gdebrun2/FlowMonitor/Plots/DPS310 Pressure Change Versus Elevation.png

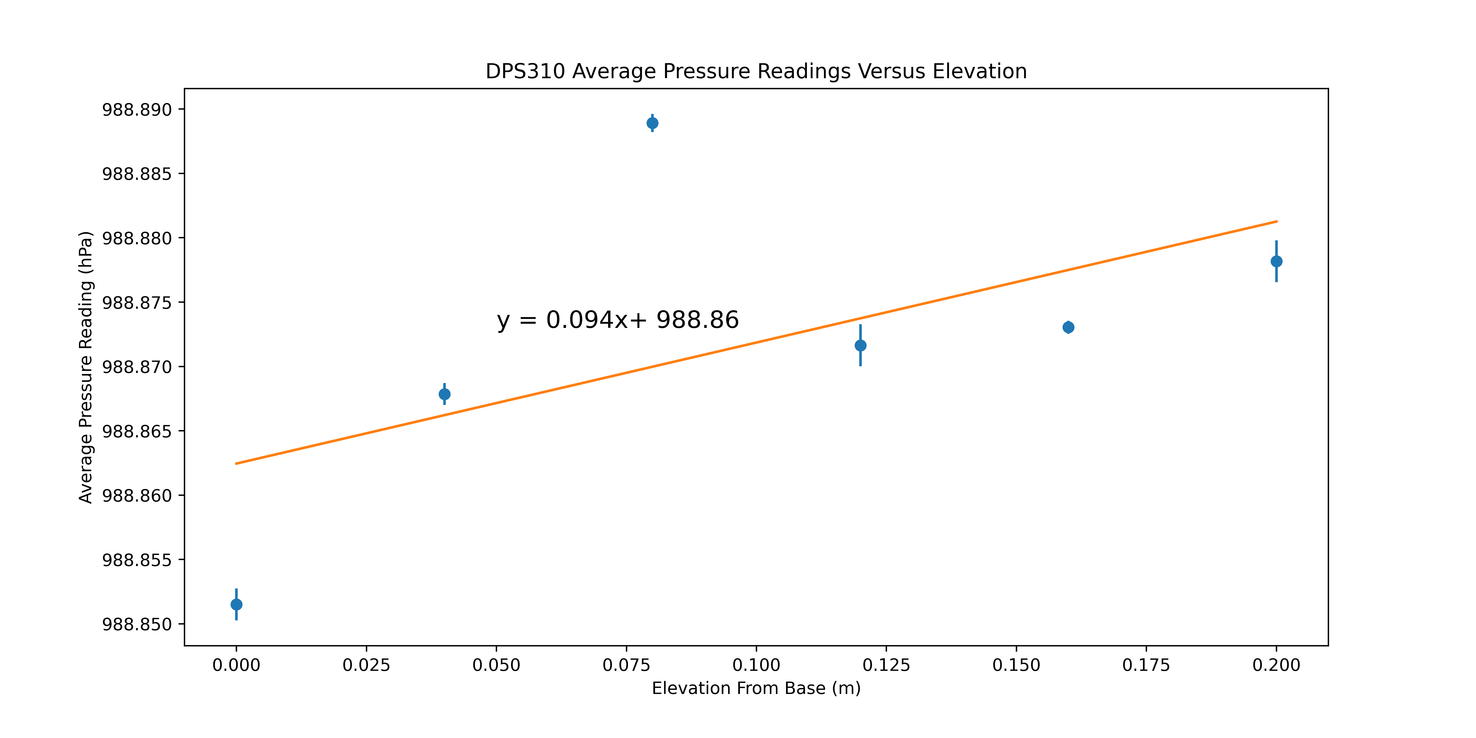
Plots/DPS310 Pressure Change Versus Elevation.png
