gdebrun2/FlowMonitor/Plots/Long Tube Plot 1.png

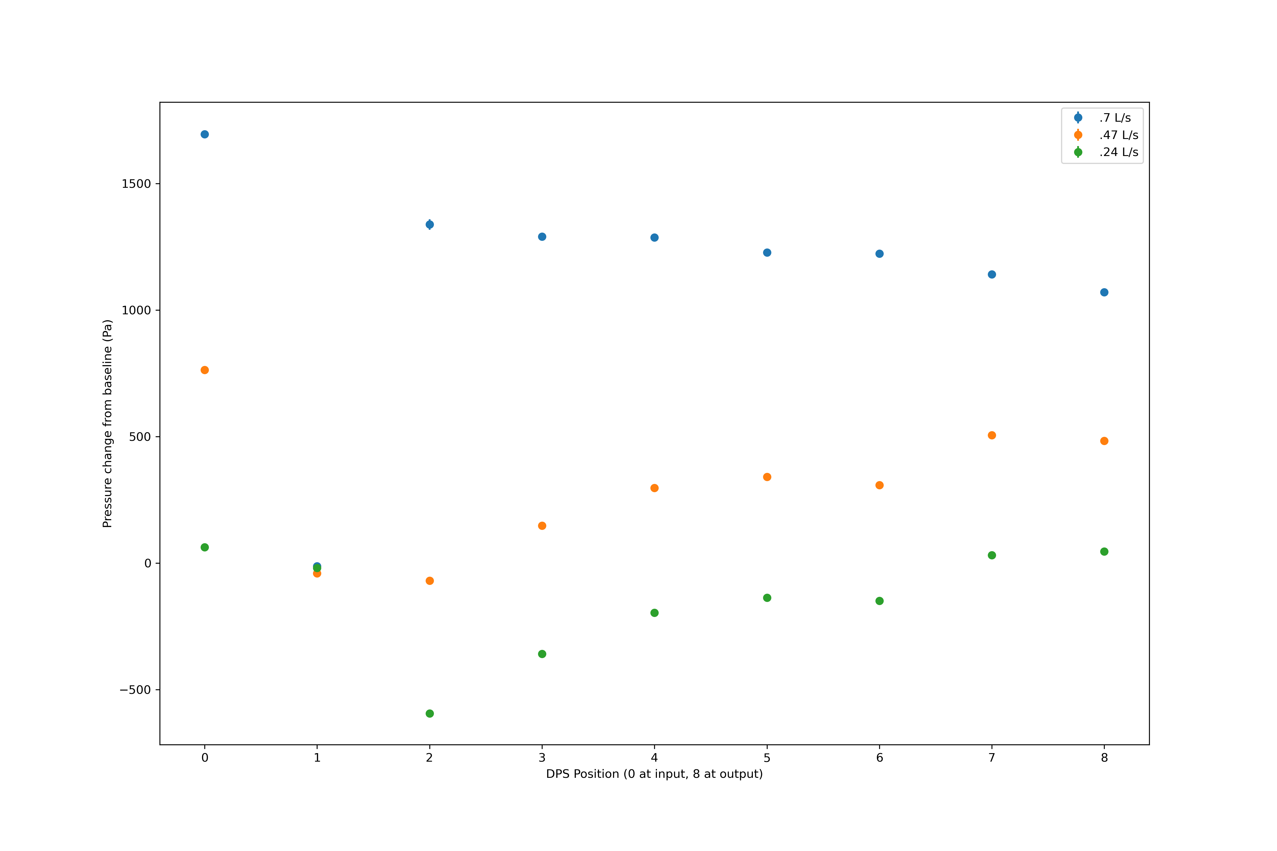
Plots/Long Tube Plot 1.png
