gdebrun2/FlowMonitor/Plots/Long Tube Plot 2.png

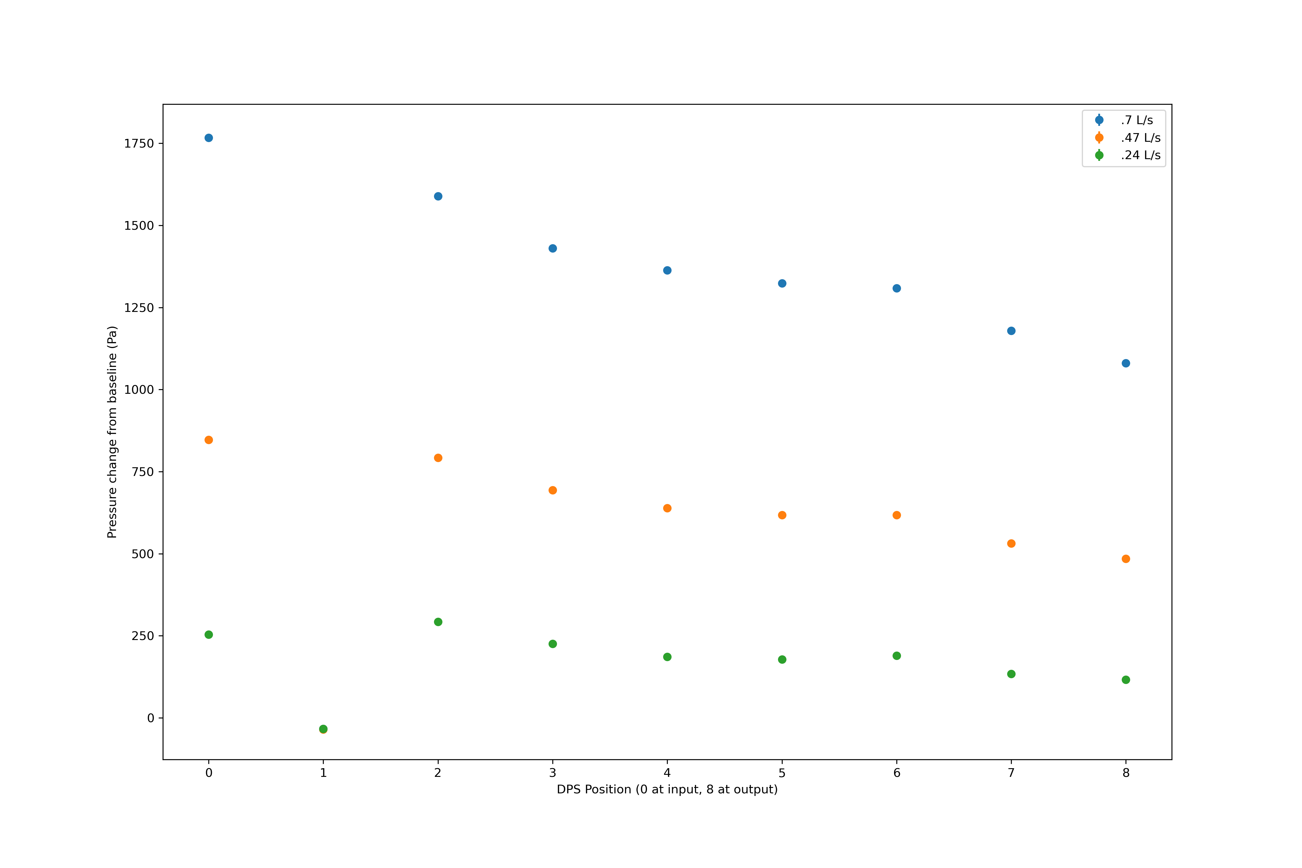
Plots/Long Tube Plot 2.png
