gdebrun2/FlowMonitor/Plots/Long Tube Plot 3.png

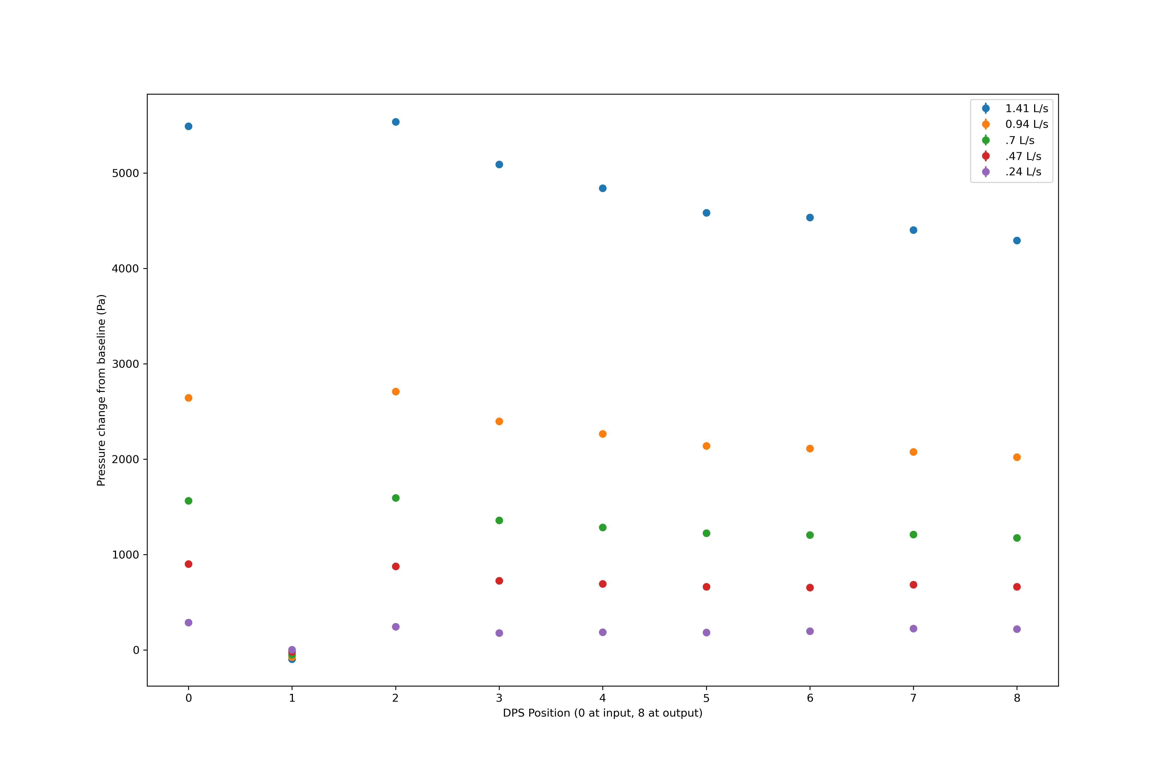
Plots/Long Tube Plot 3.png
