gdebrun2/FlowMonitor/ventilator_flowtube_15a.stl

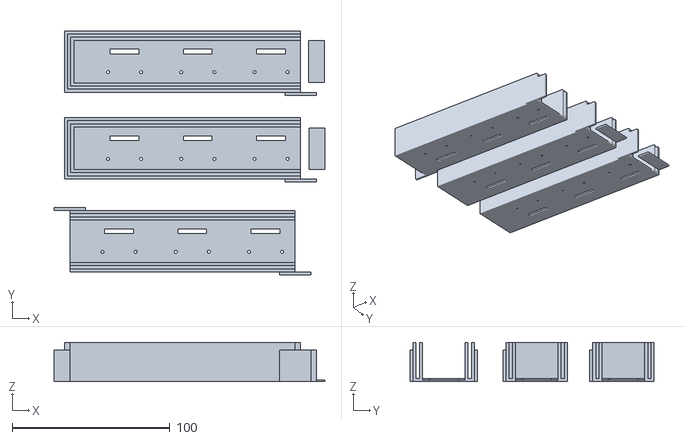
[picture p16: CAD file, 2024-03-09]
ventilator_flowtube_15a.stl
172.0 x 155.0 x 25.0
