gdebrun2/FlowMonitor/Plots/Measured Flow Rate Mean Minus Expected (Diffuser).png

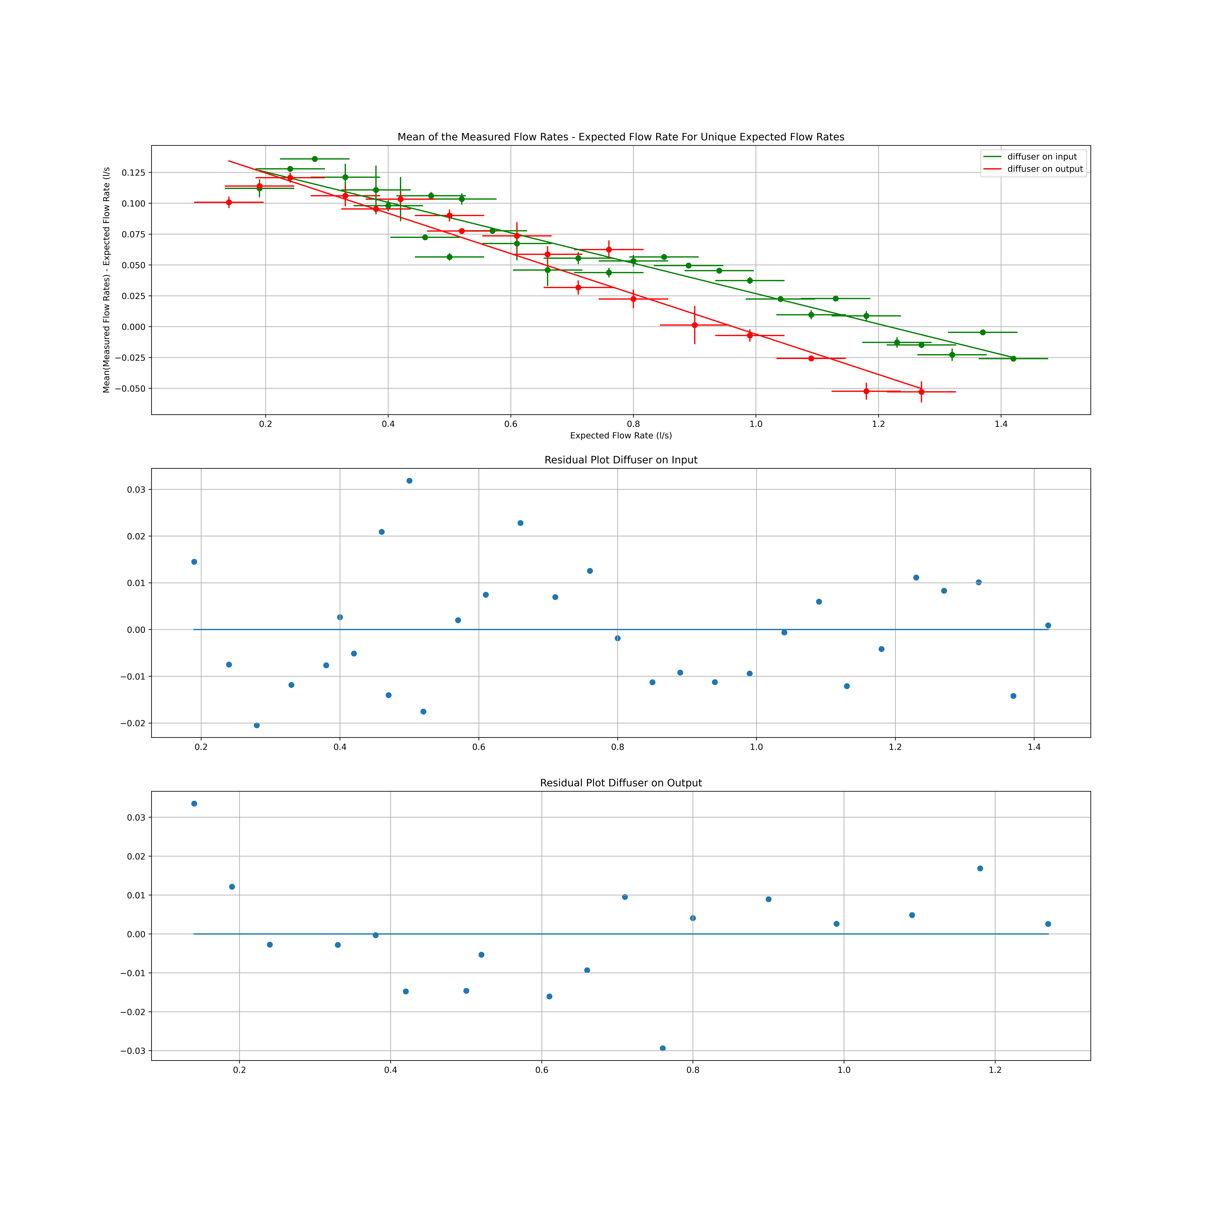
Plots/Measured Flow Rate Mean Minus Expected (Diffuser).png
