gdebrun2/FlowMonitor/Plots/Measured Flow Rate Mean Minus Expected.png

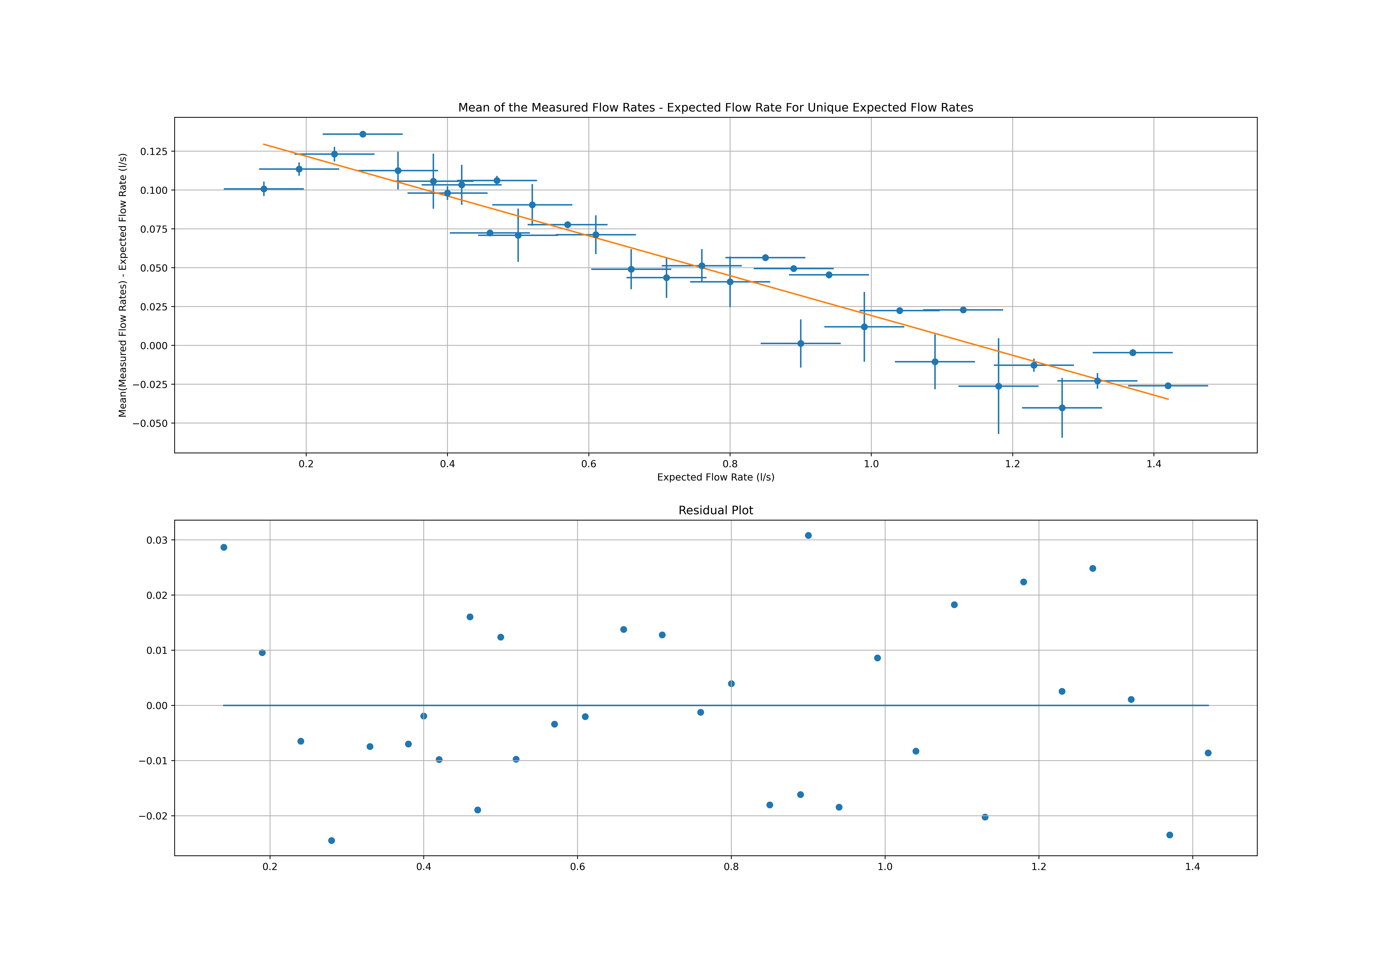
Plots/Measured Flow Rate Mean Minus Expected.png
