gdebrun2/FlowMonitor/Plots/Measured Flow Rate Minus Expected (Diffuser).png

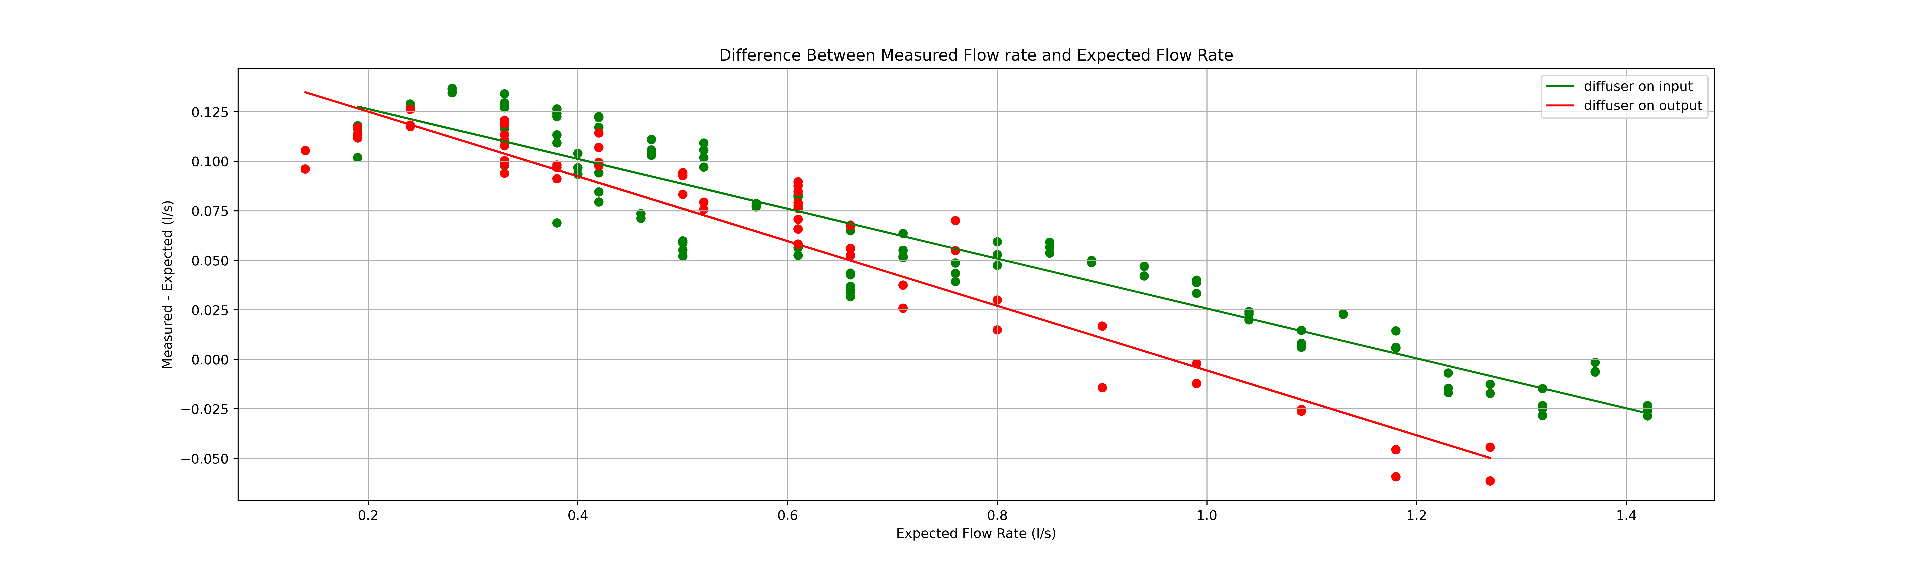
Plots/Measured Flow Rate Minus Expected (Diffuser).png
