gdebrun2/FlowMonitor/Plots/Measured Flow Rate Minus Expected.png

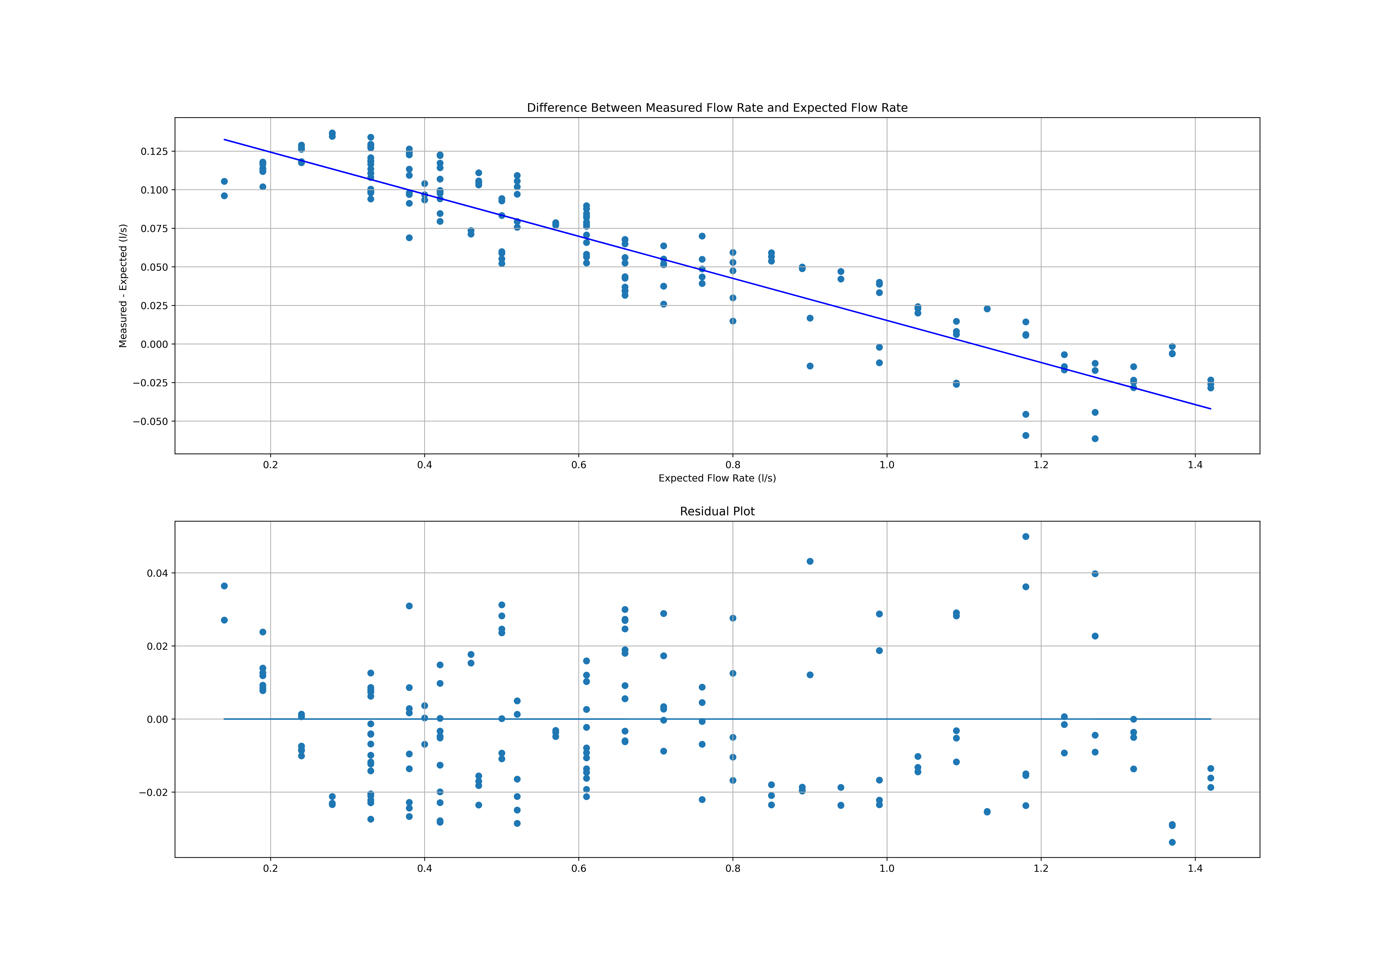
Plots/Measured Flow Rate Minus Expected.png
