gdebrun2/FlowMonitor/DAQ/RadioHead/RH_MRF89.h

// RH_MRF89.h
//
// Definitions for Microchip MRF89XA family radios radios per:
// http://ww1.microchip.com/downloads/en/DeviceDoc/70622C.pdf
// http://ww1.microchip.com/downloads/en/DeviceDoc/75017B.pdf
//
// Author: Mike McCauley (mikem@airspayce.com)
// Copyright (C) 2015 Mike McCauley
// $Id: RH_MRF89.h,v 1.6 2015/12/17 10:58:13 mikem Exp $
// 

#ifndef RH_RF95_h
#define RH_RF95_h

#include <RHNRFSPIDriver.h>

// This is the maximum number of interrupts the driver can support
// Most Arduinos can handle 2, Megas can handle more
#define RH_MRF89_NUM_INTERRUPTS 3

// Max number of octets the MRF89XA Rx/Tx FIFO can hold
#define RH_MRF89_FIFO_SIZE 64

// This is the maximum number of bytes that can be carried by the MRF89XA.
// We use some for headers, keeping fewer for RadioHead messages
#define RH_MRF89_MAX_PAYLOAD_LEN RH_MRF89_FIFO_SIZE

// The length of the headers we add.
// The headers are inside the MRF89XA payload
#define RH_MRF89_HEADER_LEN 4
    
// This is the maximum user message length that can be supported by this driver. 
// Can be pre-defined to a smaller size (to save SRAM) prior to including this header
// Here we allow for 4 bytes headers, user data. Message length and CRC are automatically encoded and decoded by 
// the MRF89XA
#ifndef RH_MRF89_MAX_MESSAGE_LEN
 #define RH_MRF89_MAX_MESSAGE_LEN (RH_MRF89_MAX_PAYLOAD_LEN - RH_MRF89_HEADER_LEN)
#endif

// Bits that must be set to do a SPI read
#define RH_MRF89_SPI_READ_MASK              0x40

// The MRF89XA crystal frequency in MHz
#define RH_MRF89_XTAL_FREQ                  12.8

// Register names from Figure 2-18
#define RH_MRF89_REG_00_GCONREG             0x00
#define RH_MRF89_REG_01_DMODREG             0x01
#define RH_MRF89_REG_02_FDEVREG             0x02
#define RH_MRF89_REG_03_BRSREG              0x03
#define RH_MRF89_REG_04_FLTHREG             0x04
#define RH_MRF89_REG_05_FIFOCREG            0x05
#define RH_MRF89_REG_06_R1CREG              0x06
#define RH_MRF89_REG_07_P1CREG              0x07
#define RH_MRF89_REG_08_S1CREG              0x08
#define RH_MRF89_REG_09_R2CREG              0x09
#define RH_MRF89_REG_0A_P2CREG              0x0a
#define RH_MRF89_REG_0B_S2CREG              0x0b
#define RH_MRF89_REG_0C_PACREG              0x0c
#define RH_MRF89_REG_0D_FTXRXIREG           0x0d
#define RH_MRF89_REG_0E_FTPRIREG            0x0e
#define RH_MRF89_REG_0F_RSTHIREG            0x0f
#define RH_MRF89_REG_10_FILCREG             0x10
#define RH_MRF89_REG_11_PFCREG              0x11
#define RH_MRF89_REG_12_SYNCREG             0x12
// Hmm the addresses of the next 2 is ambiguous in the docs
// this seems to agree with whats in the chip:
#define RH_MRF89_REG_13_RSVREG              0x13
#define RH_MRF89_REG_14_RSTSREG             0x14
#define RH_MRF89_REG_15_OOKCREG             0x15
#define RH_MRF89_REG_16_SYNCV31REG          0x16
#define RH_MRF89_REG_17_SYNCV23REG          0x17
#define RH_MRF89_REG_18_SYNCV15REG          0x18
#define RH_MRF89_REG_19_SYNCV07REG          0x19
#define RH_MRF89_REG_1A_TXCONREG            0x1a
#define RH_MRF89_REG_1B_CLKOREG             0x1b
#define RH_MRF89_REG_1C_PLOADREG            0x1c
#define RH_MRF89_REG_1D_NADDSREG            0x1d
#define RH_MRF89_REG_1E_PKTCREG             0x1e
#define RH_MRF89_REG_1F_FCRCREG             0x1f

// Register bitfield definitions
//#define RH_MRF89_REG_00_GCONREG             0x00
#define RH_MRF89_CMOD                       0xe0
#define RH_MRF89_CMOD_TRANSMIT              0x80
#define RH_MRF89_CMOD_RECEIVE               0x60
#define RH_MRF89_CMOD_FS                    0x40
#define RH_MRF89_CMOD_STANDBY               0x20
#define RH_MRF89_CMOD_SLEEP                 0x00

#define RH_MRF89_FBS                        0x18
#define RH_MRF89_FBS_950_960                0x10
#define RH_MRF89_FBS_915_928                0x08
#define RH_MRF89_FBS_902_915                0x00
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
